mdhardenburgh/deltaSigmaADC/SPICE/deltaSigmaFirstOrderModulator.asc

C1: cap; 10pF
C2: cap; 0.1µF
R1: res; 10K
R2: res; 10K
R3: res; 2K
U1: AD8541
U2: ADG1633
U4: LT1711
V1: voltage; -5
V2: voltage; 5
V5: voltage; PULSE(0 5 0 0 0 5u 10u); AC 1
V6: voltage; SINE(0 2 1000); AC 1
Named nets: 0, -5V, +5V
.ac dec 100 1 1E6
.tran 0.01
