mdhardenburgh/deltaSigmaADC/SPICE/oscilator.asc

R1: res; 10K
R2: res; 1K
R3: res; 1K
R6: res; 20K
R7: res; 20K
U1: AD8541
V1: voltage; +5
V2: voltage; -5
V3: voltage; SINE(2.5 2.5 1K)
Named nets: 0, +5V, -5V
.tran 0.1
