mdhardenburgh/deltaSigmaADC/SPICE/firstAttempt.asc

C1: cap; 1µF
C4: cap; 100pF
C6: cap; 10µF
C9: cap; 35pF
R1: res; 2K
R10: res; 100
R11: res; 100
R12: res; 100
U1: AD8541
U2: LT1394
U3: AD8541
U8: ADG1633
V1: voltage; -5
V2: voltage; 5
V5: voltage; PULSE(0 5 0 0 0 5u 10u); AC 1
V6: voltage; SINE(0 2 1000); AC 1
Named nets: 0, -5V, +5V
.ac dec 100 1 1E6
.tran 1
