mdhardenburgh/deltaSigmaADC/matlabAndSimulink/test.txt

-6.24626469088086e-19,-0.000309386982441274,-0.000528204854006731,-0.000568603872743318,-0.000384733845251966,8.00411992703799e-19,0.000478240340140162,0.000872722835015943,0.000988204049943397,0.000692866881972476,-1.31056145172967e-18,-0.000891532416184324,-0.00163296121945713,-0.00184452998485448,-0.00128447137707966,2.10513786269597e-18,0.00161758285313162,0.00292513469434517,0.00326049078201279,0.00224039932243557,-3.10636255035792e-18,-0.00274988519135346,-0.00491367845081797,-0.00541615935613394,-0.00368344907481865,4.21622866634458e-18,0.00444140560997276,0.00787802494737684,0.00862944908101731,0.00583889238263717,-5.32609478233123e-18,-0.00699531745205941,-0.0123941761878264,-0.013582437146582,-0.00921034959863475,6.32731946999318e-18,0.0111516029292688,0.0199371743819745,0.0221148625054928,0.0152357860321312,-7.12189588095948e-18,-0.0193284298248622,-0.0357407882884576,-0.0414148277856569,-0.030220139269744,7.63204533998535e-18,0.0461664134257603,0.100235498128783,0.15103852170648,0.187203448445009,0.200294681688131,0.187203448445009,0.15103852170648,0.100235498128783,0.0461664134257603,7.63204533998535e-18,-0.030220139269744,-0.0414148277856569,-0.0357407882884576,-0.0193284298248622,-7.12189588095948e-18,0.0152357860321312,0.0221148625054928,0.0199371743819745,0.0111516029292688,6.32731946999318e-18,-0.00921034959863475,-0.013582437146582,-0.0123941761878264,-0.00699531745205941,-5.32609478233123e-18,0.00583889238263717,0.00862944908101731,0.00787802494737684,0.00444140560997276,4.21622866634458e-18,-0.00368344907481865,-0.00541615935613394,-0.00491367845081797,-0.00274988519135346,-3.10636255035792e-18,0.00224039932243557,0.00326049078201279,0.00292513469434517,0.00161758285313162,2.10513786269597e-18,-0.00128447137707966,-0.00184452998485448,-0.00163296121945713,-0.000891532416184324,-1.31056145172967e-18,0.000692866881972476,0.000988204049943397,0.000872722835015943,0.000478240340140162,8.00411992703799e-19,-0.000384733845251966,-0.000568603872743318,-0.000528204854006731,-0.000309386982441274,-6.24626469088086e-19
