mdhardenburgh/deltaSigmaADC/verilog/source/uartTransmit.v

/**
 * @file uartTransmit.v
 * @engineer Matthew Hardenburgh
 * @date 4/3/19
 * @email mdhardenburgh@gmail.com
 * @brief state machine to send bits to a computer's com port
 **/

/** 
* Copyright (C) 2019  Delta Technologies
*
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
* You should have received a copy of the GNU General Public License
* along with this program. If not, see https://www.gnu.org/licenses/ 
**/

/**
 * 100MHz clock and a 921600 bit rate (baud rate)
 * (100000000) / (921600) = 108.5 clocks per bit ~ 108 clocks
 *
 * 10MHz clock and a 921600 bit rate (baud rate)
 * (10000000) / (921600) = 10.85 clocks per bit ~ 11 clocks
 *
 * 5MHz clock and a 921600 bit rate (baud rate)
 * (5000000) / (921600) = 5.425 clocks per bit ~ 5 clocks
 *
 * 1MHz clock and a 921600 bit rate (baud rate)
 * (1000000) / (921600) = 1.085 clocks per bit ~ 1 clock
 **/


/**
 * @brief serial communication module using the UART (RS232) protocol
 *
 * @input clock input
 * @input system reset input
 * @input byte of the bitstream
 * @input control flow input. Prevents reciving serial buffer overflow
 * @input data ready to be read. Data flow control bit
 *
 * @output serial transmit line
 * @output ready to accept data. Data flow control bit
 * @output test signal for debugging
 **/
module uartTransmitter #(parameter clks_per_bit = 8'd108)
(
    input clk, 
    input rst,
    input [7:0] adcInput,
    input txCtlFlow,
    input fifoEmpty, //Asserted when fifo is empty

    output reg tx,
    output reg printStatement,
    output reg firFifoReadEnable
);
    //Output for UART
    localparam startCondition = 1'b0;
    localparam endCondition = 1'b1;
    localparam stopUartTx = 1'b1;
    localparam startUartTx = 1'b0;
    localparam fifoIsEmpty  = 1'b1;
    localparam fifoIsNotEmpty  = 1'b0;

    //States
    localparam startTransmission = 2'd0;
    localparam transmitData = 2'd1;
    localparam endTransmission = 2'd2;
    localparam idleSpin = 2'd3;

    //Counter and state counter declarations
    reg[1:0] stateCounter;
    reg[7:0] binaryCounter;
    reg[1:0] endCounter;
    reg[7:0] clockCounter;

    reg[7:0] adcHold;

    always@(posedge clk, posedge rst)
    begin
        if(rst == 1'b1)
        begin
            tx <= 1'b1;
            endCounter <= 2'b0;
            binaryCounter <= 8'b0;
            clockCounter <= 8'd0;
            firFifoReadEnable <= 1'b0;
            stateCounter <= idleSpin;
        end

        else
        begin
            case(stateCounter)
            
                startTransmission:
                begin
                    tx <= startCondition;
                    if(clockCounter < clks_per_bit)
                    begin
                        clockCounter <= clockCounter + 1'b1;
                        stateCounter <= startTransmission;
                    end

                    else
                    begin
                        clockCounter <= 4'b0;
                        stateCounter <= transmitData;

                        adcHold <= adcInput;
                        firFifoReadEnable <= 1'b1;
                    end
                end

                transmitData:
                begin
                    tx <= adcHold[binaryCounter];
                    //firFifoReadEnable <= 1'b0; I commented this out
                    if(binaryCounter < 8'd8)
                    begin             
                        
                        stateCounter <= transmitData;
                        
                        if(clockCounter < clks_per_bit)
                        begin
                            clockCounter <= clockCounter + 1'b1;
                        end

                        else
                        begin
                            clockCounter <= 4'b0;
                            binaryCounter <= binaryCounter + 1'b1;
                        end

                    end

                    else
                    begin
                        stateCounter <= endTransmission;
                        binaryCounter <= 4'd0;
                    end
                end

                endTransmission:
                begin
                    tx <= endCondition;
                    firFifoReadEnable <= 1'b0;
                    if(endCounter < 2'd2)
                    begin
                        stateCounter <= endTransmission;
                        if(clockCounter < clks_per_bit)
                        begin
                            clockCounter <= clockCounter + 1'b1;
                        end

                        else
                        begin
                            clockCounter <= 4'b0;
                            endCounter <= endCounter + 1'b1;
                        end
                    end

                    else
                    begin
                        stateCounter <= idleSpin;
                        endCounter <= 2'b0;
                    end
                end

                idleSpin:
                begin
                    
                    firFifoReadEnable <= 1'b0;
                    if(txCtlFlow == stopUartTx)
                    begin
                        stateCounter <= idleSpin;
                    end

                    else
                    begin
                        stateCounter <= startTransmission;
   
                        if(fifoEmpty == fifoIsNotEmpty)
                        begin
                            stateCounter <= startTransmission;
                        end

                        else
                        begin
                            stateCounter <= idleSpin;
                        end
                    end
                end

            endcase
        end
    end
endmodule

/**
 * @brief top level module
 * 
 * @input system clock
 * @input system reset
 * @input input from delta sigma modulator
 * @input UART control flow line
 * 
 * @output UART serial output
 * @output clock for the delta sigma modulator
 * @output PLL is locked and functional. Used for debugging.
 * @output used for debugging
 **/

 //This one works
// module uartTop
// (
//     //save this for demo day
//     input clk, 
//     input rst,
//     input adcInput,
//     input txCtlFlow,
    
//     output tx,
//     output outClock,
//     output pllLocked,
//     output printStatment
// );
//     wire adcClk;
//     wire clk1;
//     wire clk2;
//     wire clk3;
//     wire clk4;
//     wire firReadyForData;
//     wire firFifoReadEnable;

//     localparam dataValid = 1'b1;

//     wire firDataValid;
//     wire firFifoEmpty;
//     wire firFifoFull;
//     wire cicReadyForData;
//     wire cicOutputValid;
//     wire[7:0] firDataStream;
//     wire[7:0] fifoDataStream;

//     wire[23:0] cicOutput;

//     clk_wiz_0 systemClock(adcClk, clk1, clk2, clk3, clk4, rst, pllLocked, clk);
//     clockSynthesizer myClock(adcClk, rst, outClock);

//     myFIR myFir(~rst, clk1, dataValid, firReadyForData, {7'b0, adcInput}, firDataValid, firDataStream);
//     fifo_generator_0 firFifo(clk2, rst, firDataStream, firDataValid, firFifoReadEnable, fifoDataStream, firFifoFull, firFifoEmpty);
//     uartTransmitter myTransmitter(clk3, rst, fifoDataStream, txCtlFlow, firFifoEmpty, tx, printStatment, firFifoReadEnable);
// endmodule


// Single FIR 
// module uartTop
// (
//     input clk, 
//     input rst,
//     input adcInput,
//     input txCtlFlow,
    
//     output tx,
//     output outClock,
//     output pllLocked,
//     output printStatment
// );
//     wire adcClk;
//     wire clk1;
//     wire clk2;
//     wire clk3;
//     wire clk4;
//     wire firReadyForData;
//     wire firFifoReadEnable;

//     wire firDataValid;
//     wire firFifoEmpty;
//     wire firFifoFull;
//     wire[7:0] firDataStream;
//     wire[7:0] fifoDataStream;

//     clk_wiz_0 systemClock(outClock, clk1, clk2, clk3, clk4, rst, pllLocked, clk);
  
//     myFIR myFir(~rst, clk1, 1'b1, firReadyForData, {7'b0000000, adcInput}, firDataValid, firDataStream);
//     fifo_generator_0 firFifo(clk2, rst, firDataStream, firDataValid, firFifoReadEnable, fifoDataStream, firFifoFull, firFifoEmpty);
//     uartTransmitter myTransmitter(clk3, rst, fifoDataStream, txCtlFlow, firFifoEmpty, tx, printStatment, firFifoReadEnable);
// endmodule

//CIC filter used
module uartTop
(
    input clk, 
    input rst,
    input adcInput,
    input txCtlFlow,
    
    output tx,
    output outClock,
    output pllLocked,
    output printStatment
);
    wire adcClk;
    wire clk1;
    wire clk2;
    wire clk3;
    wire clk4;
    wire cicReadyForData;
    wire firFifoReadEnable;

    wire cicDataValid;
    wire fifoEmpty;
    wire fifoFull;
    wire[31:0] cicDataStream;
    wire[7:0] fifoDataStream;

    clk_wiz_0 systemClock(outClock, clk1, clk2, clk3, clk4, rst, pllLocked, clk);

    assign printStatment = fifoEmpty;
    cic_compiler_0 myCic(clk, ~rst, {7'b0000000, adcInput}, 1'b1, cicReadyForData, cicDataStream, cicDataValid);
    fifo_generator_0 firFifo(clk2, rst, cicDataStream, cicDataValid, firFifoReadEnable, fifoDataStream, fifoFull, fifoEmpty);
    uartTransmitter myTransmitter(clk3, rst, fifoDataStream, txCtlFlow, fifoEmpty, tx, printStatment, firFifoReadEnable);
endmodule
