mdhardenburgh/deltaSigmaADC/(commit log)

2019-04-15 updated uart transmitter
2019-08-15 commit of finished project
    [sigmaDeltaADC.kicad_pcb, sigmaDeltaADC.sch]
2019-08-15 updated BOM and project details
2019-08-15 Numbered componets
    [sigmaDeltaADC.sch]
